PawelCzopek/StacjaPogodowa/program/stacjaPogodowa004/charakters.h

byte customChar[8] ={
                      B01110,
                      B01010,
                      B01110,
                      B00000,
                      B00000,
                      B00000,
                      B00000,
                      B00000
                     };//stopien
